janscience/FishFinder/docs/hardware.md

# Hardware

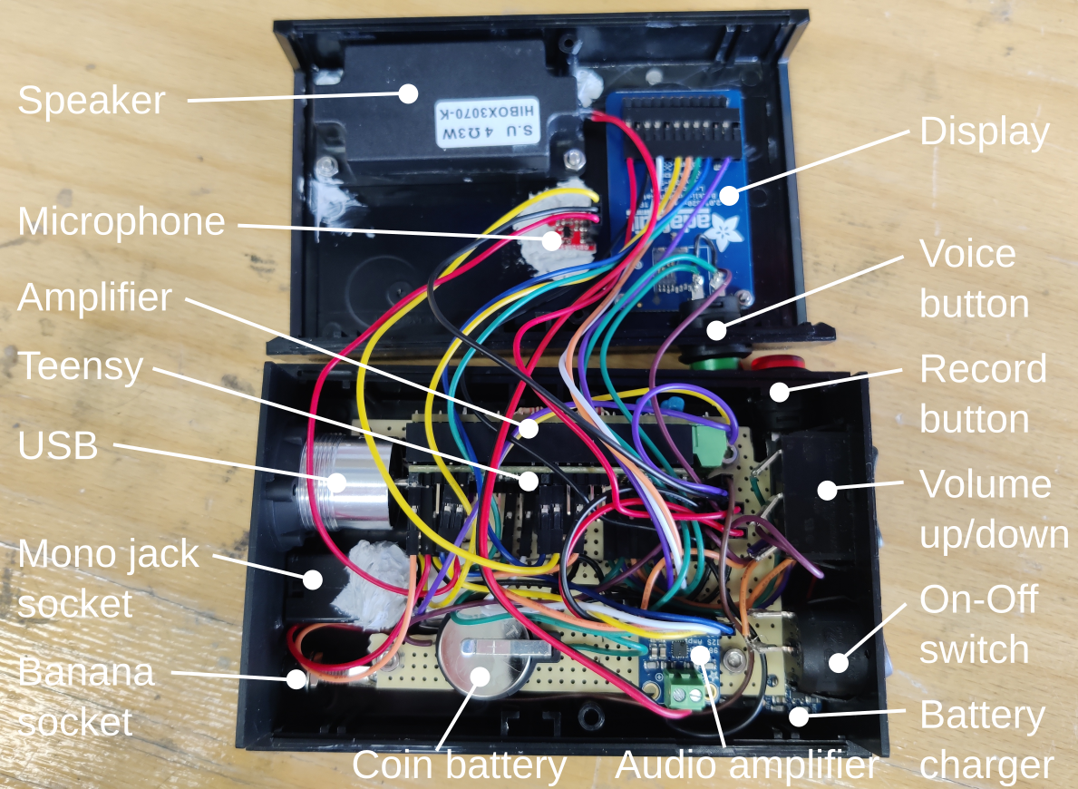
[picture p9: docs/images/fishfinder-v1a-hardware.png]
hardware


- Amplifier: [Teensy_Amp
  R3.0](https://github.com/janscience/Teensy_Amp/tree/main/R3.0)
- Microcontroller: [Teensy 3.5](https://www.pjrc.com/store/teensy35.html)
- Battery charger: [Adafruit LiIon/LiPoly
  Backpack](https://www.adafruit.com/product/2124)
- Battery (below the PCB): [3.7V 2000mAh Lithium Polymer
  Akku](https://www.exp-tech.de/zubehoer/batterien-akkus/lipo-akkus/6329/3.7v-2000mah-lithium-polymer-akku-mit-jst-ph-anschluss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)
- Audio amplifier: [Adafruit MAX98357 I2S Class-D Mono
  Amp](https://learn.adafruit.com/adafruit-max98357-i2s-class-d-mono-amp)
- Speaker: [Adafruit mono enclosed speaker
  3W](https://www.adafruit.com/product/3351)
- Display: [Adafruit 2.0" 320x240 Color IPS TFT
  Display](https://www.adafruit.com/product/4311)
- Microphone: [SparkFun Analog MEMS
  Microphone](https://www.sparkfun.com/products/18011)
- USB micro connector: [TRU components 1365796](https://www.conrad.de/de/p/micro-usb-einbaubuchse-2-0-buchse-einbau-micro-usb-01-micro-usb-buchse-auf-micro-usb-stecker-1365796-tru-components-inh-1365796.html)
- Mono jack socket 6.3mm: [Switchcraft 157](https://www.mouser.de/ProductDetail/502-157)
- Mono jack 6.3mm: [Hicon HI-J63MP-B](https://www.conrad.de/de/p/hicon-hi-j63mp-b-klinken-steckverbinder-6-35-mm-stecker-gerade-polzahl-num-2-mono-schwarz-1-st-1541221.html)
- Banana socket: [Schützinger IBU 5568](https://www.conrad.de/de/p/schuetzinger-ibu-5568-ni-sw-einbaubuchse-schwarz-1-st-2342971.html)
- Coin battery holder: [TRU components CH26-2032LF](https://www.conrad.de/de/p/tru-components-ch26-2032lf-knopfzellenhalter-1x-cr-2032-kontaktpole-1672595.html)
- On/off switch: [TRU components Wippschalter R13-112A-02](https://www.conrad.de/de/p/tru-components-wippschalter-r13-112a-02-bb-on-off-250-v-ac-6-a-1-x-aus-ein-rastend-1-st-1565960.html)
- Record (red), voice-message (green), volume up/down (blue) buttons: [TRU components GQ12B-A](https://www.conrad.de/de/p/tru-components-gq12b-a-bl-vandalismusgeschuetzter-drucktaster-48-v-dc-2-a-1-x-aus-ein-tastend-ip65-1-st-701260.html)
- Housing: [63000-510-000 CM3-150 Black Kit](https://www.mouser.de/ProductDetail/616-63000-510-000)

## Pinout

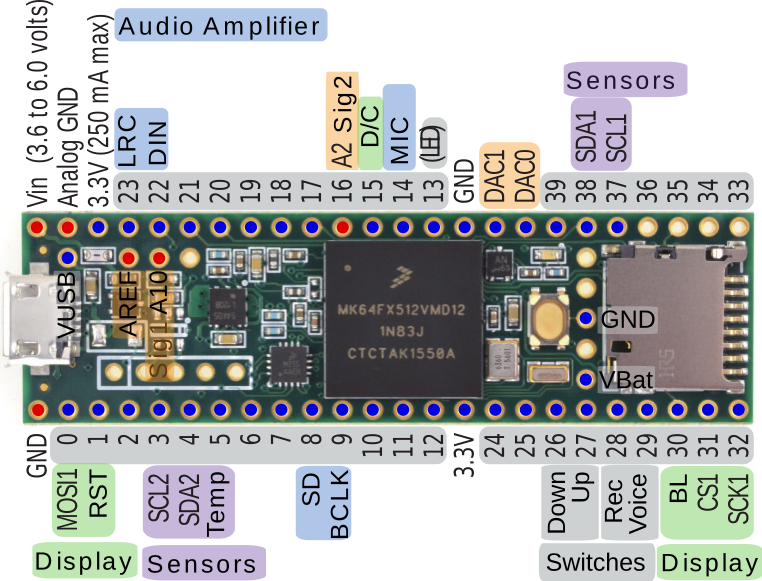
[picture p10: docs/images/fishfinder-teensy3.5-pinout.png]
pinout


### Amplifier

[Teensy_Amp R3.0](https://github.com/janscience/Teensy_Amp/tree/main/R3.0)

- A2
- A10

### Display

[Adafruit 2.0" 320x240 Color IPS TFT Display](https://www.adafruit.com/product/4311) on SPI1:

- MOSI1: 0
- D/C: 15
- RST: 1
- SCK1: 32
- CS1: 31
- BL: 30
- GND
- 3.3V

### Audio amplifier:

[Adafruit MAX98357 I2S Class-D Mono Amp](https://learn.adafruit.com/adafruit-max98357-i2s-class-d-mono-amp)

- LRC: 23
- BCLK: 9
- DIN: 22
- GAIN: GND (12dB gain)
- SD: 8
- GND
- 3.3V

### Microphone

[SparkFun Analog MEMS Microphone](https://www.sparkfun.com/products/18011)

- GND
- 3.3V
- A0

### Switches

- Volume down: 26
- Volume up: 27
- Record: 28
- Voice message: 29

### Real time clock con battery

- GND
- VBAT

### LiPo Charger

[Adafruit LiIon/LiPoly Backpack](https://www.adafruit.com/product/2124)

- VUSB
- Vin
- GND
