janscience/FishFinder/docs/images/fishfinder-v1a-hardware.jpg

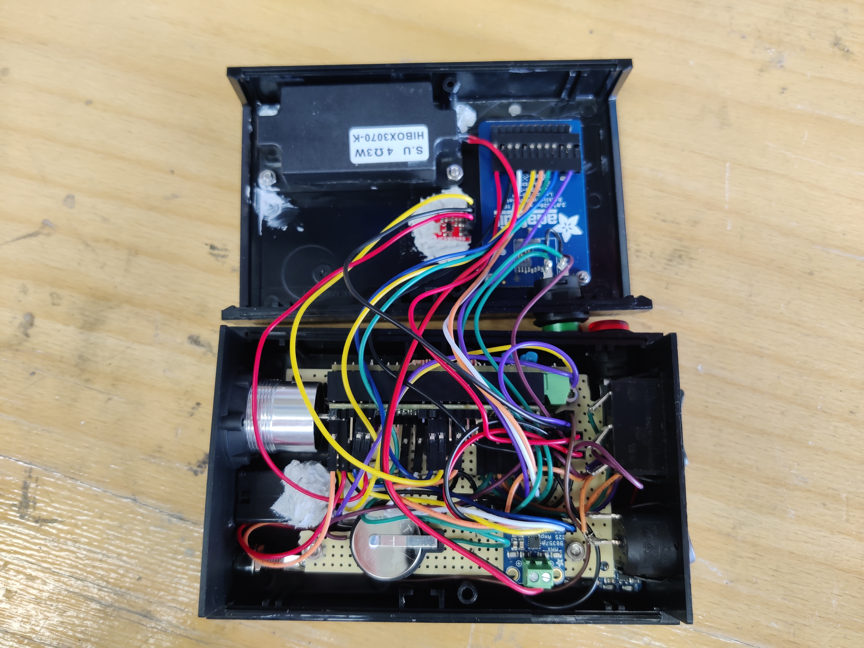
docs/images/fishfinder-v1a-hardware.jpg
