janscience/FishFinder/docs/images/fishfinder-v1a-inputs.jpg

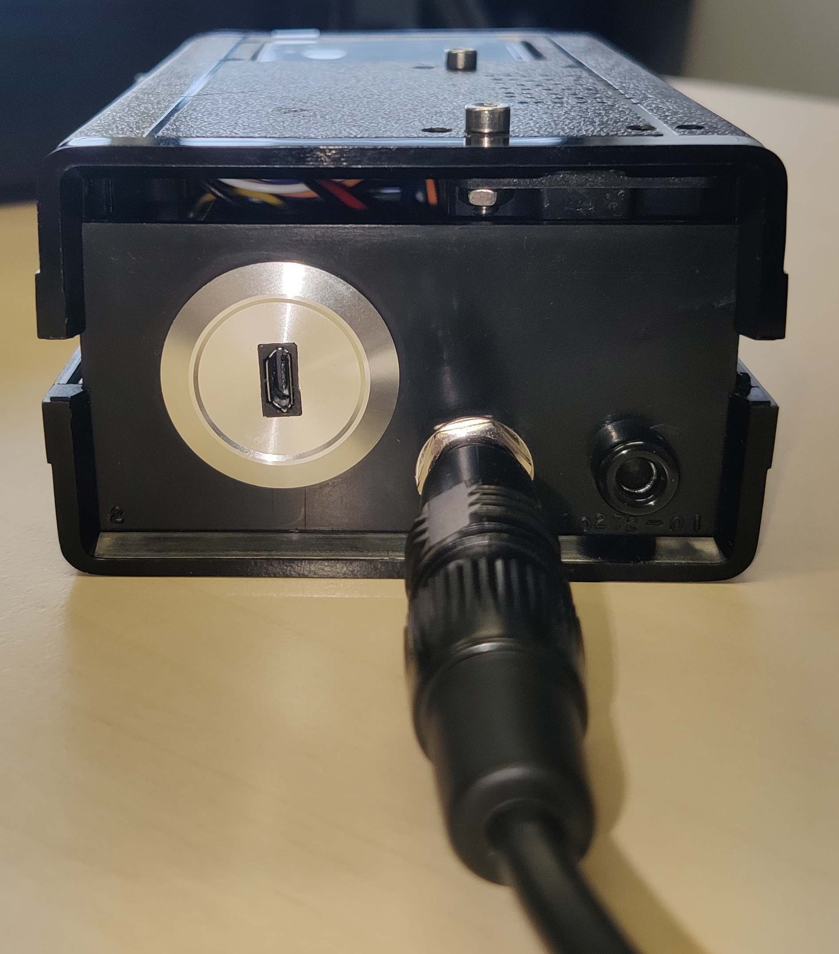
docs/images/fishfinder-v1a-inputs.jpg
