janscience/FishFinder/R42-fishrecorder/images/fishrecorder1-amplifier.jpg

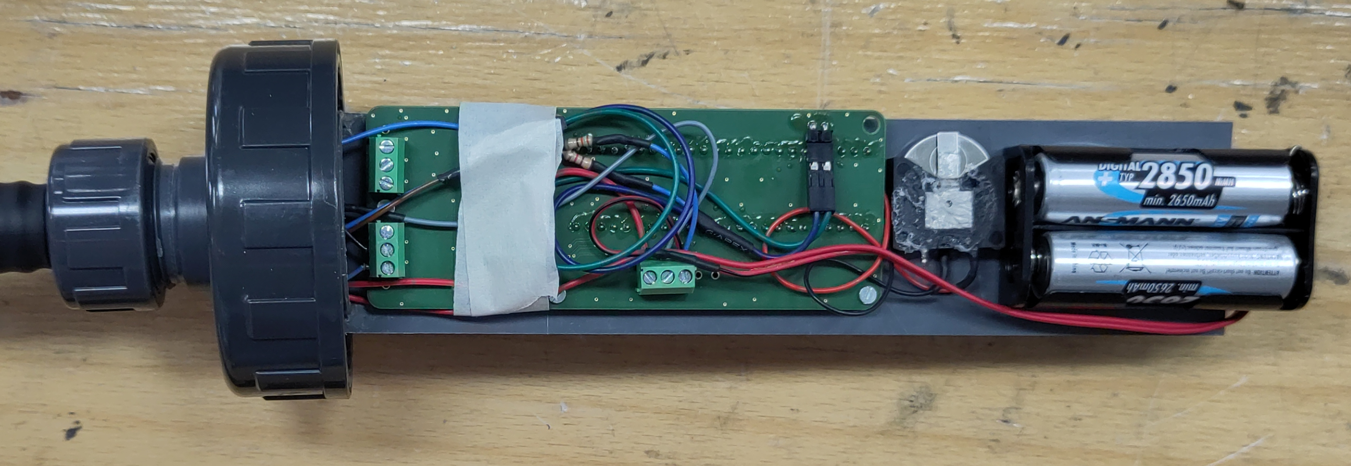
R42-fishrecorder/images/fishrecorder1-amplifier.jpg
