janscience/FishFinder/R42-fishrecorder/images/fishrecorder1-teensy.jpg

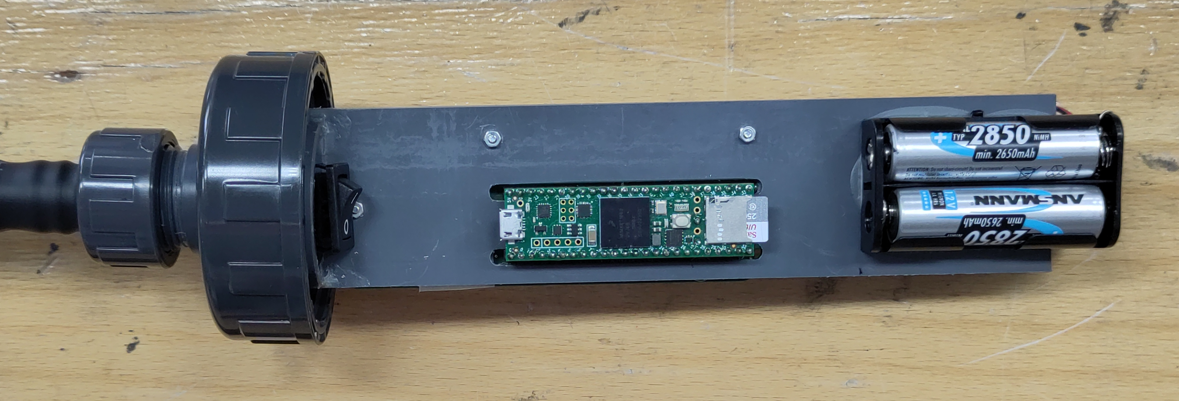
R42-fishrecorder/images/fishrecorder1-teensy.jpg
