janscience/FishFinder/docs/images/fishfinder-teensy3.5-pinout.pdf

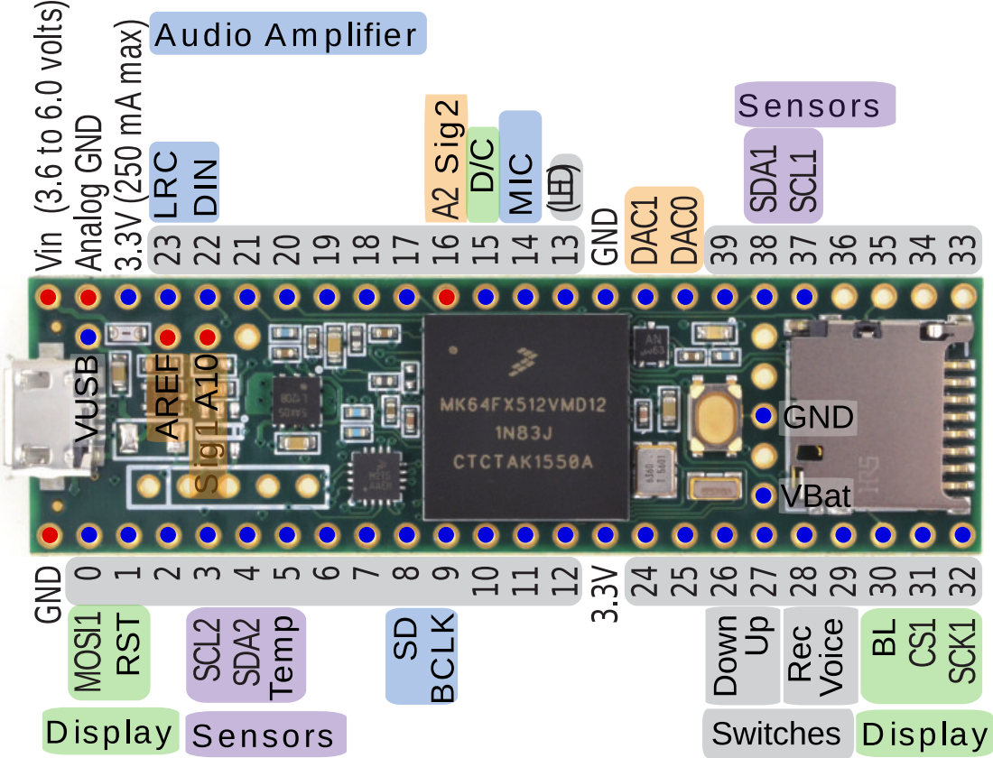
[picture p17: page 1]
