janscience/FishFinder/mtpfiletransfer/mtpfiletransfer.ino

// Just run the MTP responder on the default SD card.

// You need to:
// git clone git@github.com:KurtE/MTP_Teensy.git
// Requires Teensyduino >=1.57, set USB Type to "Serial + MTP Disk"

#include <SD.h>
#include <MTP_Teensy.h>


void setup() {
  Serial.begin(9600);
  while (!Serial && millis() < 200) {};
  SD.begin(BUILTIN_SDCARD);
  MTP.begin();
  MTP.addFilesystem(SD, "Fishfinder");
}


void loop() {
  MTP.loop();
}
