janscience/FishFinder/(commit log)

2022-06-18 [fishfinder] new Analyzer framework
2022-06-20 [doc] power consumption
2022-06-23 [docs] fishfinder electrodes
2022-06-24 [docs] organized fishfinder electrode discussion
2022-06-30 fixed display pins for SPI1
    [fishfinder.ino]
2022-07-09 added battery charger
2022-07-09 updated electrode overview
2022-07-14 [docs] added description of operation of switches
2022-12-13 record button disables voice message period
2022-12-15 stop MTP mode via record button
2022-12-17 added framework for initial menu
2022-12-17 MTP can be canceled with any button
2022-12-27 renamed ContinuousADC to TeensyADC
2022-12-28 first update to TeensyADCSettings
2022-12-28 multiple fishfinder and logger ADC settings
2023-01-07 introduced device name
2023-01-07 added device name to EEPROM
2023-02-06 added sketch for central electrode
2023-02-10 proper field line resistances
2023-02-12 [electrodes] improved comment on stereo and mono jacks
2023-02-19 [electrodes] updated fishfinder code
2023-07-17 worked on gain channel switch
2023-08-29 renamed TeensyADC to InputADC
2023-10-20 [R42-fishrecorder] do nut power off the second pcm!
2023-10-21 [R42-fishrecorder] power down of second pcm
2025-08-27 [R42-fishfinder] added buttons
2025-08-27 [R42-fishfinder] pin wire colors
